CADname/NEXis/edge_vision/requirements_core.txt

numpy>=1.26,<2.0
opencv-python==4.10.0.84
requests>=2.32,<3
cv2-enumerate-cameras==1.1.12
