CADname/NEXis/app/web/assets/rig_reference.png

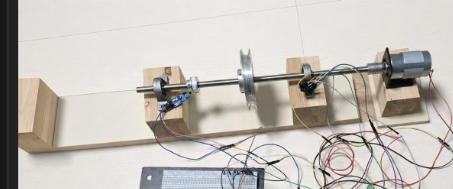
app/web/assets/rig_reference.png
