CADname/NEXis/docs/evaluation/feature_importance.csv

feature | importance
vib_ax_fft_total_energy | 0.022841326941740757
vib_ax_centered_rms | 0.021518155046494087
ax_rms | 0.021321313642015755
ax_fft_total_energy | 0.019961500723639985
ax_mean_abs_diff | 0.018666930597677878
vib_ax_q05 | 0.018539132703501063
vib_ax_std | 0.01814061380089551
ax_centered_rms | 0.01775506041951234
ax_var | 0.01736891581041225
ax_std | 0.01585659368558779
vib_ax_q95 | 0.01584396396627282
ax_iqr | 0.014160836240362438
ax_q95 | 0.014040463257992202
vib_ax_mean_abs_diff | 0.013955982796245478
vib_ax_iqr | 0.01363182951508748
ax_q05 | 0.013531222460089153
pwm_eq_median | 0.01277275607882244
pwm_eq_min | 0.011442873997963907
pwm_eq_q05 | 0.011442207293568114
ax_q75 | 0.011145094145351761
ay_median | 0.010799129972839763
vib_ax_q25 | 0.010654076008571609
pwm_eq_q75 | 0.010268697937284216
current_a_rms | 0.01020383544681336
pwm_eq_rms | 0.010178003566090188
pwm_eq_mean | 0.009994177080974014
pwm_eq_q95 | 0.009784141094847007
vib_ax_var | 0.00975105574194405
vib_ax_fft_15_30hz | 0.009672639114409732
ay_mean | 0.009424310437024592
acs_v_q95 | 0.009088402274476421
current_abs_mean_over_pwm_mean | 0.009057602223819976
pwm_eq_q25 | 0.008910322613374079
acs_v_rms | 0.008840024011165869
vib_ax_q75 | 0.008527674537947201
current_a_q05 | 0.008377809314269248
current_a_mean | 0.007773108881717905
pwm_eq_max | 0.007617440874078626
vib_ax_rms | 0.007548050671091398
current_a_q95 | 0.007475737540474022
acs_v_q25 | 0.007419951414322092
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
rpm_var | 0.00011975944122605263
vib_ay_dominant_freq | 0.00011945600777226854
rpm_fft_0_5hz | 0.00011679042688848543
vib_total_dominant_freq | 0.00011668877949068922
rpm_error_iqr | 0.00011223443318074505
rpm_error_ptp | 0.00010559064158554448
rpm_std | 0.00010518689751538301
rpm_iqr | 0.00010289869426213125
rpm_error_fft_15_30hz | 0.0001014084815672207
rpm_fft_total_energy | 9.811545128408473e-05
current_a_fft_0_5hz | 9.785438429443867e-05
acs_v_ptp | 9.752379922287292e-05
rpm_error_centered_rms | 9.72223357891814e-05
rpm_centered_rms | 9.585941786660273e-05
rpm_error_std | 9.481525569085122e-05
acs_v_spectral_spread | 9.313141887709359e-05
rpm_error_fft_0_5hz | 9.255021409763322e-05
total_current_corr | 9.033770345591622e-05
rpm_fft_15_30hz | 8.775610676664932e-05
rpm_error_var | 8.479115660224636e-05
rpm_fft_30_50hz | 7.97908124904852e-05
rpm_crest_factor | 7.911407737408273e-05
current_a_crest_factor | 7.814628266932045e-05
total_g_dominant_freq | 7.742065601655996e-05
acs_v_fft_0_5hz | 7.085889173998369e-05
ay_current_corr | 6.81832499439148e-05
az_current_corr | 6.512588289561261e-05
rpm_error_crest_factor | 6.033289721847867e-05
rpm_zcr | 6.0223892591135575e-05
rpm_vib_total_corr | 5.899271610973664e-05
rpm_error_zcr | 5.8956073629024985e-05
acs_v_crest_factor | 5.660127188325421e-05
ax_current_corr | 5.379428782710225e-05
rpm_spectral_spread | 4.242318456284739e-05
rpm_error_fft_total_energy | 4.161761290725309e-05
rpm_spectral_centroid | 4.065409392491601e-05
rpm_error_spectral_spread | 3.951437715421174e-05
rpm_error_spectral_centroid | 2.759924141874203e-05
rpm_error_dominant_freq | 1.8747235652247775e-05
rpm_current_corr | 1.4626233459767611e-05
rpm_dominant_freq | 1.039781791317215e-06
target_rpm_mean | 0.0
target_rpm_std | 0.0
vib_az_mean | 0.0
vib_total_mean | 0.0
pwm_eq_iqr | 0.0
pwm_eq_var | 0.0
pwm_eq_std | 0.0
duty_10bit_fft_total_energy | 0.0
duty_10bit_max_abs_diff | 0.0
duty_10bit_mean_abs_diff | 0.0
duty_10bit_zcr | 0.0
duty_10bit_crest_factor | 0.0
duty_10bit_ptp | 0.0
duty_10bit_centered_rms | 0.0
duty_10bit_iqr | 0.0
duty_10bit_var | 0.0
duty_10bit_std | 0.0
pwm_eq_spectral_spread | 0.0
pwm_eq_spectral_centroid | 0.0
pwm_eq_dominant_freq | 0.0
pwm_eq_fft_30_50hz | 0.0
pwm_eq_fft_15_30hz | 0.0
vib_ax_mean | 0.0
pwm_eq_fft_total_energy | 0.0
pwm_eq_max_abs_diff | 0.0
pwm_eq_zcr | 0.0
pwm_eq_mean_abs_diff | 0.0
pwm_eq_fft_5_15hz | 0.0
pwm_eq_fft_0_5hz | 0.0
pwm_eq_centered_rms | 0.0
pwm_eq_ptp | 0.0
vib_ay_mean | 0.0
duty_10bit_fft_5_15hz | 0.0
duty_10bit_dominant_freq | 0.0
duty_10bit_spectral_spread | 0.0
duty_10bit_fft_0_5hz | 0.0
duty_10bit_fft_15_30hz | 0.0
duty_10bit_fft_30_50hz | 0.0
duty_10bit_spectral_centroid | 0.0
