CADname/NEXis/docs/evaluation/csv_structure_check.csv

file | label | rows | rpm_mean | rpm_std | rpm_min | rpm_max | target_rpm_mean | rpm_error_mean | rpm_error_std | pwm_eq_mean | pwm_eq_std | acs_v_mean | acs_v_std | current_a_mean | current_a_std | ax_std | ay_std | az_std | total_g_std | state_mode | fault_type_mode
looseness_1000rpm_20261003_182908.csv | looseness | 989 | 1013.7632760364003 | 4.158534391472891 | 1005.48 | 1018.02 | 1000.0 | -13.763276036400404 | 4.158534391472892 | 50.25 | 0.0 | 2.22141213346815 | 0.008476578495732462 | -0.4937592517694641 | 0.12843413964583206 | 0.13910724921763432 | 0.22425402340945075 | 0.1594633347641606 | 0.1522566400938172 | 3 | looseness
looseness_1000rpm_20261003_182921.csv | looseness | 919 | 1025.1019477693146 | 2.1134196734731168 | 1021.35 | 1028.22 | 1000.0 | -25.10194776931447 | 2.1134196734731208 | 50.25 | 0.0 | 2.2219379760609357 | 0.008311339907777037 | -0.48579064200217625 | 0.12592871872577033 | 0.11853777779041468 | 0.23668175885504308 | 0.1668040516732486 | 0.15704965667657458 | 3 | looseness
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
