CADname/NEXis/docs/evaluation/file_validation.csv

model | test_file | true_label | true_label_name | pred_label | pred_label_name | file_correct | pred_file_ratio | pred_file_mean_prob | window_accuracy
RandomForest_fast | looseness_1000rpm_20261003_182908.csv | 3 | looseness | 3 | looseness | True | 1.0 | 0.9712121212121212 | 1.0
RandomForest_fast | looseness_1000rpm_20261003_182921.csv | 3 | looseness | 3 | looseness | True | 1.0 | 0.9768595041322314 | 1.0
RandomForest_fast | looseness_1000rpm_20261003_182935.csv | 3 | looseness | 3 | looseness | True | 1.0 | 0.9689393939393939 | 1.0
RandomForest_fast | looseness_1000rpm_20261003_182947.csv | 3 | looseness | 3 | looseness | True | 1.0 | 0.9825757575757575 | 1.0
RandomForest_fast | looseness_1000rpm_20261003_182959.csv | 3 | looseness | 3 | looseness | True | 1.0 | 0.9810606060606061 | 1.0
RandomForest_fast | looseness_1000rpm_20261003_183013.csv | 3 | looseness | 3 | looseness | True | 1.0 | 0.9810606060606061 | 1.0
RandomForest_fast | looseness_1000rpm_20261003_183025.csv | 3 | looseness | 3 | looseness | True | 1.0 | 0.8856060606060606 | 1.0
RandomForest_fast | looseness_1000rpm_20261003_183037.csv | 3 | looseness | 3 | looseness | True | 1.0 | 0.9962121212121214 | 1.0
RandomForest_fast | looseness_1000rpm_20261003_183055.csv | 3 | looseness | 3 | looseness | True | 1.0 | 0.9753787878787877 | 1.0
RandomForest_fast | looseness_1000rpm_20261003_183107.csv | 3 | looseness | 3 | looseness | True | 1.0 | 0.9830578512396694 | 1.0
RandomForest_fast | looseness_1000rpm_20261003_183118.csv | 3 | looseness | 3 | looseness | True | 1.0 | 0.968595041322314 | 1.0
RandomForest_fast | looseness_1000rpm_20261003_183131.csv | 3 | looseness | 3 | looseness | True | 1.0 | 0.975378787878788 | 1.0
RandomForest_fast | looseness_1000rpm_20261003_183146.csv | 3 | looseness | 3 | looseness | True | 1.0 | 0.9602272727272726 | 1.0
RandomForest_fast | looseness_1000rpm_20261003_183210.csv | 3 | looseness | 3 | looseness | True | 1.0 | 0.983712121212121 | 1.0
RandomForest_fast | looseness_1000rpm_20261003_183224.csv | 3 | looseness | 3 | looseness | True | 1.0 | 0.9268595041322314 | 1.0
RandomForest_fast | looseness_1000rpm_20261003_183236.csv | 3 | looseness | 3 | looseness | True | 1.0 | 0.9878787878787878 | 1.0
RandomForest_fast | looseness_1000rpm_20261003_183247.csv | 3 | looseness | 3 | looseness | True | 1.0 | 0.952651515151515 | 1.0
RandomForest_fast | looseness_1000rpm_20261003_183300.csv | 3 | looseness | 3 | looseness | True | 1.0 | 0.912121212121212 | 1.0
RandomForest_fast | looseness_1000rpm_20261003_184720.csv | 3 | looseness | 3 | looseness | True | 1.0 | 0.834469696969697 | 1.0
RandomForest_fast | looseness_1000rpm_20261003_184739.csv | 3 | looseness | 3 | looseness | True | 1.0 | 0.7609848484848486 | 1.0
RandomForest_fast | looseness_1000rpm_20261003_190001.csv | 3 | looseness | 3 | looseness | True | 1.0 | 0.9257575757575758 | 1.0
RandomForest_fast | looseness_1000rpm_20261003_190017.csv | 3 | looseness | 3 | looseness | True | 1.0 | 0.8924242424242422 | 1.0
RandomForest_fast | looseness_1000rpm_20261003_190035.csv | 3 | looseness | 3 | looseness | True | 1.0 | 0.9416666666666665 | 1.0
RandomForest_fast | looseness_1000rpm_20261003_190050.csv | 3 | looseness | 3 | looseness | True | 1.0 | 0.971969696969697 | 1.0
RandomForest_fast | looseness_1000rpm_20261003_190104.csv | 3 | looseness | 3 | looseness | True | 1.0 | 0.9768939393939394 | 1.0
RandomForest_fast | looseness_1000rpm_20261003_190116.csv | 3 | looseness | 3 | looseness | True | 1.0 | 0.953409090909091 | 1.0
RandomForest_fast | looseness_1000rpm_20261003_190135.csv | 3 | looseness | 3 | looseness | True | 1.0 | 0.9511363636363636 | 1.0
RandomForest_fast | looseness_1000rpm_20261003_190150.csv | 3 | looseness | 3 | looseness | True | 1.0 | 0.9507575757575758 | 1.0
RandomForest_fast | looseness_1000rpm_20261003_190201.csv | 3 | looseness | 3 | looseness | True | 1.0 | 0.9636363636363637 | 1.0
RandomForest_fast | looseness_1000rpm_20261003_190214.csv | 3 | looseness | 3 | looseness | True | 1.0 | 0.9060606060606061 | 1.0
RandomForest_fast | looseness_1000rpm_20261003_190234.csv | 3 | looseness | 3 | looseness | True | 1.0 | 0.8435606060606061 | 1.0
RandomForest_fast | looseness_1000rpm_20261003_190247.csv | 3 | looseness | 3 | looseness | True | 1.0 | 0.8309917355371902 | 1.0
RandomForest_fast | looseness_1000rpm_20261003_190308.csv | 3 | looseness | 3 | looseness | True | 1.0 | 0.9818181818181818 | 1.0
RandomForest_fast | looseness_1000rpm_20261003_190325.csv | 3 | looseness | 3 | looseness | True | 1.0 | 0.9875000000000002 | 1.0
RandomForest_fast | looseness_1000rpm_20261003_190338.csv | 3 | looseness | 3 | looseness | True | 1.0 | 0.8768939393939394 | 1.0
RandomForest_fast | looseness_1000rpm_20261003_190400.csv | 3 | looseness | 3 | looseness | True | 1.0 | 0.9325757575757575 | 1.0
RandomForest_fast | looseness_1000rpm_20261003_002418.csv | 3 | looseness | 3 | looseness | True | 1.0 | 0.8136363636363636 | 1.0
RandomForest_fast | looseness_1000rpm_20261003_002435.csv | 3 | looseness | 3 | looseness | True | 1.0 | 0.8848484848484848 | 1.0
RandomForest_fast | looseness_1000rpm_20261003_002450.csv | 3 | looseness | 3 | looseness | True | 1.0 | 0.9363636363636362 | 1.0
RandomForest_fast | looseness_1000rpm_20261003_002511.csv | 3 | looseness | 3 | looseness | True | 1.0 | 0.6983471074380164 | 1.0
RandomForest_fast | looseness_1000rpm_20261003_002525.csv | 3 | looseness | 3 | looseness | True | 1.0 | 0.9016528925619837 | 1.0
RandomForest_fast | looseness_1000rpm_20261003_002557.csv | 3 | looseness | 3 | looseness | True | 1.0 | 0.9526515151515151 | 1.0
RandomForest_fast | looseness_1000rpm_20261003_002628.csv | 3 | looseness | 3 | looseness | True | 1.0 | 0.8958677685950412 | 1.0
RandomForest_fast | looseness_1000rpm_20261003_002644.csv | 3 | looseness | 3 | looseness | True | 1.0 | 0.9125 | 1.0
RandomForest_fast | looseness_1000rpm_20261003_230148.csv | 3 | looseness | 3 | looseness | True | 1.0 | 0.9602272727272728 | 1.0
RandomForest_fast | looseness_1000rpm_20261003_230201.csv | 3 | looseness | 3 | looseness | True | 1.0 | 0.9568181818181817 | 1.0
RandomForest_fast | looseness_1000rpm_20261003_230237.csv | 3 | looseness | 3 | looseness | True | 1.0 | 0.9859504132231405 | 1.0
RandomForest_fast | looseness_1000rpm_20261003_230302.csv | 3 | looseness | 3 | looseness | True | 1.0 | 0.9892561983471073 | 1.0
RandomForest_fast | looseness_1000rpm_20261003_230317.csv | 3 | looseness | 3 | looseness | True | 1.0 | 0.9445454545454546 | 1.0
RandomForest_fast | looseness_1000rpm_20261003_230345.csv | 3 | looseness | 3 | looseness | True | 1.0 | 0.934090909090909 | 1.0
RandomForest_fast | looseness_1000rpm_20261003_230400.csv | 3 | looseness | 3 | looseness | True | 1.0 | 0.9351239669421488 | 1.0
RandomForest_fast | looseness_1000rpm_20261003_230411.csv | 3 | looseness | 3 | looseness | True | 1.0 | 0.9698347107438017 | 1.0
RandomForest_fast | looseness_1000rpm_20261003_230430.csv | 3 | looseness | 3 | looseness | True | 1.0 | 0.9665289256198348 | 1.0
RandomForest_fast | looseness_1000rpm_20261003_230444.csv | 3 | looseness | 3 | looseness | True | 1.0 | 0.9446280991735537 | 1.0
RandomForest_fast | looseness_1000rpm_20261003_230458.csv | 3 | looseness | 3 | looseness | True | 1.0 | 0.9793388429752067 | 1.0
RandomForest_fast | looseness_1000rpm_20261003_232731.csv | 3 | looseness | 3 | looseness | True | 1.0 | 0.9583916083916084 | 1.0
RandomForest_fast | looseness_1000rpm_20261003_232744.csv | 3 | looseness | 3 | looseness | True | 1.0 | 0.9904958677685951 | 1.0
RandomForest_fast | looseness_1000rpm_20261003_232756.csv | 3 | looseness | 3 | looseness | True | 1.0 | 0.9892561983471075 | 1.0
RandomForest_fast | looseness_1000rpm_20261003_232807.csv | 3 | looseness | 3 | looseness | True | 1.0 | 0.9787878787878787 | 1.0
RandomForest_fast | looseness_1000rpm_20261003_232824.csv | 3 | looseness | 3 | looseness | True | 1.0 | 0.975 | 1.0
RandomForest_fast | looseness_1000rpm_20261003_232848.csv | 3 | looseness | 3 | looseness | True | 1.0 | 0.9772727272727273 | 1.0
RandomForest_fast | looseness_1000rpm_20261003_232901.csv | 3 | looseness | 3 | looseness | True | 1.0 | 0.9897727272727272 | 1.0
RandomForest_fast | looseness_1000rpm_20261003_232914.csv | 3 | looseness | 3 | looseness | True | 1.0 | 0.9859848484848485 | 1.0
RandomForest_fast | looseness_1000rpm_20261003_232927.csv | 3 | looseness | 3 | looseness | True | 1.0 | 0.9777272727272728 | 1.0
RandomForest_fast | looseness_1000rpm_20261003_232941.csv | 3 | looseness | 3 | looseness | True | 1.0 | 0.9392561983471073 | 1.0
RandomForest_fast | looseness_1000rpm_20261003_233007.csv | 3 | looseness | 3 | looseness | True | 1.0 | 0.9483471074380165 | 1.0
RandomForest_fast | looseness_1000rpm_20261003_233225.csv | 3 | looseness | 3 | looseness | True | 1.0 | 0.9882575757575757 | 1.0
RandomForest_fast | looseness_1000rpm_20261003_233248.csv | 3 | looseness | 3 | looseness | True | 1.0 | 0.9904958677685951 | 1.0
RandomForest_fast | looseness_1000rpm_20261003_233315.csv | 3 | looseness | 3 | looseness | True | 1.0 | 0.9863636363636364 | 1.0
RandomForest_fast | looseness_1000rpm_20261003_233616.csv | 3 | looseness | 3 | looseness | True | 1.0 | 0.9818181818181819 | 1.0
RandomForest_fast | looseness_1000rpm_20261003_233635.csv | 3 | looseness | 3 | looseness | True | 1.0 | 0.9674242424242424 | 1.0
RandomForest_fast | looseness_1000rpm_20261003_233658.csv | 3 | looseness | 3 | looseness | True | 1.0 | 0.9926573426573425 | 1.0
RandomForest_fast | looseness_1000rpm_20261003_233715.csv | 3 | looseness | 3 | looseness | True | 1.0 | 0.9852272727272727 | 1.0
RandomForest_fast | looseness_1000rpm_20261003_233732.csv | 3 | looseness | 3 | looseness | True | 1.0 | 0.9776515151515152 | 1.0
RandomForest_fast | looseness_1000rpm_20261003_233743.csv | 3 | looseness | 3 | looseness | True | 1.0 | 0.9822314049586776 | 1.0
RandomForest_fast | looseness_1000rpm_20261003_000001.csv | 3 | looseness | 3 | looseness | True | 1.0 | 0.8305785123966942 | 1.0
RandomForest_fast | looseness_1000rpm_20261003_000024.csv | 3 | looseness | 3 | looseness | True | 1.0 | 0.9349999999999999 | 1.0
RandomForest_fast | looseness_1000rpm_20261003_000101.csv | 3 | looseness | 3 | looseness | True | 1.0 | 0.864090909090909 | 1.0
RandomForest_fast | looseness_1000rpm_20261003_000132.csv | 3 | looseness | 3 | looseness | True | 1.0 | 0.8669421487603305 | 1.0
RandomForest_fast | looseness_1000rpm_20261003_000158.csv | 3 | looseness | 3 | looseness | True | 1.0 | 0.8314049586776858 | 1.0
RandomForest_fast | misalignment_1000rpm_20261002_204030.csv | 2 | misalignment | 2 | misalignment | True | 1.0 | 0.9681818181818181 | 1.0
RandomForest_fast | misalignment_1000rpm_20261002_204042.csv | 2 | misalignment | 2 | misalignment | True | 1.0 | 0.9742424242424242 | 1.0
RandomForest_fast | misalignment_1000rpm_20261002_204057.csv | 2 | misalignment | 2 | misalignment | True | 1.0 | 0.956439393939394 | 1.0
RandomForest_fast | misalignment_1000rpm_20261002_204109.csv | 2 | misalignment | 2 | misalignment | True | 1.0 | 0.9488636363636362 | 1.0
RandomForest_fast | misalignment_1000rpm_20261002_204122.csv | 2 | misalignment | 2 | misalignment | True | 1.0 | 0.9905303030303031 | 1.0
RandomForest_fast | misalignment_1000rpm_20261002_204146.csv | 2 | misalignment | 2 | misalignment | True | 1.0 | 0.6950757575757575 | 1.0
RandomForest_fast | misalignment_1000rpm_20261002_204206.csv | 2 | misalignment | 2 | misalignment | True | 1.0 | 0.9518939393939395 | 1.0
RandomForest_fast | misalignment_1000rpm_20261002_204217.csv | 2 | misalignment | 2 | misalignment | True | 1.0 | 0.9814393939393938 | 1.0
RandomForest_fast | misalignment_1000rpm_20261002_204229.csv | 2 | misalignment | 2 | misalignment | True | 1.0 | 0.9852272727272725 | 1.0
RandomForest_fast | misalignment_1000rpm_20261002_204248.csv | 2 | misalignment | 2 | misalignment | True | 1.0 | 0.9784090909090909 | 1.0
RandomForest_fast | misalignment_1000rpm_20261002_204304.csv | 2 | misalignment | 2 | misalignment | True | 1.0 | 0.9897727272727272 | 1.0
RandomForest_fast | misalignment_1000rpm_20261002_204315.csv | 2 | misalignment | 2 | misalignment | True | 1.0 | 0.983712121212121 | 1.0
RandomForest_fast | misalignment_1000rpm_20261002_204658.csv | 2 | misalignment | 2 | misalignment | True | 1.0 | 0.9912878787878788 | 1.0
RandomForest_fast | misalignment_1000rpm_20261002_204709.csv | 2 | misalignment | 2 | misalignment | True | 1.0 | 0.9878787878787879 | 1.0
RandomForest_fast | misalignment_1000rpm_20261002_204720.csv | 2 | misalignment | 2 | misalignment | True | 1.0 | 0.9795454545454545 | 1.0
RandomForest_fast | misalignment_1000rpm_20261002_204731.csv | 2 | misalignment | 2 | misalignment | True | 1.0 | 0.9928030303030303 | 1.0
RandomForest_fast | misalignment_1000rpm_20261002_204750.csv | 2 | misalignment | 2 | misalignment | True | 1.0 | 0.9882575757575758 | 1.0
RandomForest_fast | misalignment_1000rpm_20261002_204810.csv | 2 | misalignment | 2 | misalignment | True | 1.0 | 0.9613636363636363 | 1.0
RandomForest_fast | misalignment_1000rpm_20261002_204821.csv | 2 | misalignment | 2 | misalignment | True | 1.0 | 0.9833333333333333 | 1.0
RandomForest_fast | misalignment_1000rpm_20261002_222054.csv | 2 | misalignment | 2 | misalignment | True | 1.0 | 0.890530303030303 | 1.0
RandomForest_fast | misalignment_1000rpm_20261002_222105.csv | 2 | misalignment | 2 | misalignment | True | 1.0 | 0.9144628099173552 | 1.0
RandomForest_fast | misalignment_1000rpm_20261002_222117.csv | 2 | misalignment | 2 | misalignment | True | 1.0 | 0.9337121212121211 | 1.0
RandomForest_fast | misalignment_1000rpm_20261002_222129.csv | 2 | misalignment | 2 | misalignment | True | 1.0 | 0.9348484848484849 | 1.0
RandomForest_fast | misalignment_1000rpm_20261002_222140.csv | 2 | misalignment | 2 | misalignment | True | 1.0 | 0.921590909090909 | 1.0
RandomForest_fast | misalignment_1000rpm_20261002_225101.csv | 2 | misalignment | 2 | misalignment | True | 1.0 | 0.9621212121212123 | 1.0
RandomForest_fast | misalignment_1000rpm_20261002_225112.csv | 2 | misalignment | 2 | misalignment | True | 1.0 | 0.962396694214876 | 1.0
RandomForest_fast | misalignment_1000rpm_20261002_225124.csv | 2 | misalignment | 2 | misalignment | True | 1.0 | 0.9636363636363637 | 1.0
RandomForest_fast | misalignment_1000rpm_20261002_225135.csv | 2 | misalignment | 2 | misalignment | True | 1.0 | 0.9648760330578512 | 1.0
RandomForest_fast | misalignment_1000rpm_20261002_225154.csv | 2 | misalignment | 2 | misalignment | True | 1.0 | 0.9640151515151515 | 1.0
RandomForest_fast | misalignment_1000rpm_20261002_225207.csv | 2 | misalignment | 2 | misalignment | True | 1.0 | 0.978030303030303 | 1.0
RandomForest_fast | misalignment_1000rpm_20261002_225226.csv | 2 | misalignment | 2 | misalignment | True | 1.0 | 0.9140909090909091 | 1.0
RandomForest_fast | misalignment_1000rpm_20261002_225238.csv | 2 | misalignment | 2 | misalignment | True | 1.0 | 0.9338842975206613 | 1.0
RandomForest_fast | misalignment_1000rpm_20261002_230437.csv | 2 | misalignment | 2 | misalignment | True | 1.0 | 0.734090909090909 | 1.0
RandomForest_fast | misalignment_1000rpm_20261002_230448.csv | 2 | misalignment | 2 | misalignment | True | 1.0 | 0.6609848484848485 | 1.0
RandomForest_fast | misalignment_1000rpm_20261002_230506.csv | 2 | misalignment | 2 | misalignment | True | 1.0 | 0.8946280991735538 | 1.0
RandomForest_fast | misalignment_1000rpm_20261002_230521.csv | 2 | misalignment | 2 | misalignment | True | 1.0 | 0.8655303030303031 | 1.0
RandomForest_fast | misalignment_1000rpm_20261002_231617.csv | 2 | misalignment | 2 | misalignment | True | 1.0 | 0.7734848484848484 | 1.0
RandomForest_fast | misalignment_1000rpm_20261002_231631.csv | 2 | misalignment | 2 | misalignment | True | 1.0 | 0.8079545454545456 | 1.0
RandomForest_fast | misalignment_1000rpm_20261002_231647.csv | 2 | misalignment | 2 | misalignment | True | 1.0 | 0.8609848484848485 | 1.0
RandomForest_fast | misalignment_1000rpm_20261002_231709.csv | 2 | misalignment | 2 | misalignment | True | 1.0 | 0.8409090909090908 | 1.0
RandomForest_fast | misalignment_1000rpm_20261002_231721.csv | 2 | misalignment | 2 | misalignment | True | 1.0 | 0.8830578512396695 | 1.0
RandomForest_fast | misalignment_1000rpm_20261002_233257.csv | 2 | misalignment | 2 | misalignment | True | 1.0 | 0.9268595041322314 | 1.0
RandomForest_fast | misalignment_1000rpm_20261002_233309.csv | 2 | misalignment | 2 | misalignment | True | 1.0 | 0.9173553719008264 | 1.0
RandomForest_fast | misalignment_1000rpm_20261002_233324.csv | 2 | misalignment | 2 | misalignment | True | 0.9166666666666666 | 0.7382575757575758 | 0.9166666666666666
RandomForest_fast | misalignment_1000rpm_20261002_233340.csv | 2 | misalignment | 2 | misalignment | True | 1.0 | 0.8920454545454547 | 1.0
RandomForest_fast | misalignment_1000rpm_20261002_233400.csv | 2 | misalignment | 2 | misalignment | True | 1.0 | 0.7962809917355372 | 1.0
RandomForest_fast | misalignment_1000rpm_20261002_233413.csv | 2 | misalignment | 2 | misalignment | True | 1.0 | 0.9206611570247933 | 1.0
RandomForest_fast | misalignment_1000rpm_20261002_233428.csv | 2 | misalignment | 2 | misalignment | True | 1.0 | 0.6863636363636364 | 1.0
RandomForest_fast | misalignment_1000rpm_20261002_233447.csv | 2 | misalignment | 2 | misalignment | True | 1.0 | 0.8363636363636363 | 1.0
RandomForest_fast | misalignment_1000rpm_20261002_233503.csv | 2 | misalignment | 2 | misalignment | True | 1.0 | 0.8169421487603308 | 1.0
RandomForest_fast | misalignment_1000rpm_20261002_223814.csv | 2 | misalignment | 2 | misalignment | True | 1.0 | 0.9512396694214877 | 1.0
RandomForest_fast | misalignment_1000rpm_20261002_223830.csv | 2 | misalignment | 2 | misalignment | True | 1.0 | 0.5045454545454546 | 1.0
RandomForest_fast | misalignment_1000rpm_20261002_223845.csv | 2 | misalignment | 2 | misalignment | True | 1.0 | 0.849586776859504 | 1.0
RandomForest_fast | misalignment_1000rpm_20261002_225704.csv | 2 | misalignment | 0 | normal | False | 1.0 | 0.6109848484848485 | 0.0
RandomForest_fast | misalignment_1000rpm_20261002_225735.csv | 2 | misalignment | 0 | normal | False | 1.0 | 0.6927272727272727 | 0.0
RandomForest_fast | misalignment_1000rpm_20261002_225752.csv | 2 | misalignment | 0 | normal | False | 1.0 | 0.6508264462809917 | 0.0
RandomForest_fast | misalignment_1000rpm_20261002_234315.csv | 2 | misalignment | 2 | misalignment | True | 1.0 | 0.5016528925619835 | 1.0
RandomForest_fast | misalignment_1000rpm_20261002_234344.csv | 2 | misalignment | 0 | normal | False | 1.0 | 0.518595041322314 | 0.0
RandomForest_fast | misalignment_1000rpm_20261002_223620.csv | 2 | misalignment | 2 | misalignment | True | 1.0 | 0.7840909090909092 | 1.0
RandomForest_fast | misalignment_1000rpm_20261002_223646.csv | 2 | misalignment | 2 | misalignment | True | 1.0 | 0.5621212121212121 | 1.0
RandomForest_fast | misalignment_1000rpm_20261002_223721.csv | 2 | misalignment | 2 | misalignment | True | 0.8333333333333334 | 0.5431818181818181 | 0.8333333333333334
RandomForest_fast | misalignment_1000rpm_20261002_212235.csv | 2 | misalignment | 0 | normal | False | 1.0 | 0.49132231404958676 | 0.0
RandomForest_fast | misalignment_1000rpm_20261002_212427.csv | 2 | misalignment | 2 | misalignment | True | 1.0 | 0.41856060606060613 | 1.0
RandomForest_fast | normal_1000rpm_20261002_175246.csv | 0 | normal | 0 | normal | True | 1.0 | 0.9928030303030303 | 1.0
RandomForest_fast | normal_1000rpm_20261002_175304.csv | 0 | normal | 0 | normal | True | 1.0 | 0.9882575757575758 | 1.0
RandomForest_fast | normal_1000rpm_20261002_175317.csv | 0 | normal | 0 | normal | True | 1.0 | 0.9905303030303031 | 1.0
RandomForest_fast | normal_1000rpm_20261002_175342.csv | 0 | normal | 0 | normal | True | 1.0 | 0.9901515151515152 | 1.0
RandomForest_fast | normal_1000rpm_20261002_175354.csv | 0 | normal | 0 | normal | True | 1.0 | 0.9863636363636363 | 1.0
RandomForest_fast | normal_1000rpm_20261002_175405.csv | 0 | normal | 0 | normal | True | 1.0 | 0.993939393939394 | 1.0
RandomForest_fast | normal_1000rpm_20261002_175417.csv | 0 | normal | 0 | normal | True | 1.0 | 0.9856060606060607 | 1.0
RandomForest_fast | normal_1000rpm_20261002_175442.csv | 0 | normal | 0 | normal | True | 1.0 | 0.9378787878787879 | 1.0
RandomForest_fast | normal_1000rpm_20261002_175454.csv | 0 | normal | 0 | normal | True | 1.0 | 0.9977272727272727 | 1.0
RandomForest_fast | normal_1000rpm_20261002_175505.csv | 0 | normal | 0 | normal | True | 1.0 | 0.9867424242424243 | 1.0
RandomForest_fast | normal_1000rpm_20261002_175517.csv | 0 | normal | 0 | normal | True | 1.0 | 0.9954545454545456 | 1.0
RandomForest_fast | normal_1000rpm_20261002_175531.csv | 0 | normal | 0 | normal | True | 1.0 | 0.9890151515151516 | 1.0
RandomForest_fast | normal_1000rpm_20261002_175543.csv | 0 | normal | 0 | normal | True | 1.0 | 0.9880165289256198 | 1.0
RandomForest_fast | normal_1000rpm_20261002_175606.csv | 0 | normal | 0 | normal | True | 1.0 | 0.9727272727272727 | 1.0
RandomForest_fast | normal_1000rpm_20261002_175617.csv | 0 | normal | 0 | normal | True | 1.0 | 0.9886363636363638 | 1.0
RandomForest_fast | normal_1000rpm_20261002_175630.csv | 0 | normal | 0 | normal | True | 1.0 | 0.9916666666666667 | 1.0
RandomForest_fast | normal_1000rpm_20261002_175641.csv | 0 | normal | 0 | normal | True | 1.0 | 0.994318181818182 | 1.0
RandomForest_fast | normal_1000rpm_20261002_175654.csv | 0 | normal | 0 | normal | True | 1.0 | 0.9863636363636364 | 1.0
RandomForest_fast | normal_1000rpm_20261002_190750.csv | 0 | normal | 0 | normal | True | 1.0 | 0.9768939393939394 | 1.0
RandomForest_fast | normal_1000rpm_20261002_190802.csv | 0 | normal | 0 | normal | True | 1.0 | 0.981439393939394 | 1.0
RandomForest_fast | normal_1000rpm_20261002_190813.csv | 0 | normal | 0 | normal | True | 1.0 | 0.8212121212121213 | 1.0
RandomForest_fast | normal_1000rpm_20261002_190831.csv | 0 | normal | 0 | normal | True | 1.0 | 0.9749999999999998 | 1.0
RandomForest_fast | normal_1000rpm_20261002_190906.csv | 0 | normal | 0 | normal | True | 1.0 | 0.9818181818181819 | 1.0
RandomForest_fast | normal_1000rpm_20261002_190919.csv | 0 | normal | 0 | normal | True | 1.0 | 0.975378787878788 | 1.0
RandomForest_fast | normal_1000rpm_20261002_190931.csv | 0 | normal | 0 | normal | True | 1.0 | 0.9575757575757575 | 1.0
RandomForest_fast | normal_1000rpm_20261002_190945.csv | 0 | normal | 0 | normal | True | 1.0 | 0.9617424242424243 | 1.0
RandomForest_fast | normal_1000rpm_20261002_221954.csv | 0 | normal | 0 | normal | True | 1.0 | 0.8303030303030304 | 1.0
RandomForest_fast | normal_1000rpm_20261002_222005.csv | 0 | normal | 0 | normal | True | 1.0 | 0.7765151515151515 | 1.0
RandomForest_fast | normal_1000rpm_20261002_222017.csv | 0 | normal | 0 | normal | True | 1.0 | 0.846969696969697 | 1.0
RandomForest_fast | normal_1000rpm_20261002_230321.csv | 0 | normal | 0 | normal | True | 0.8181818181818182 | 0.6384297520661156 | 0.8181818181818182
RandomForest_fast | normal_1000rpm_20261002_230334.csv | 0 | normal | 0 | normal | True | 0.9090909090909091 | 0.6640495867768595 | 0.9090909090909091
RandomForest_fast | normal_1000rpm_20261002_230345.csv | 0 | normal | 0 | normal | True | 1.0 | 0.6057851239669423 | 1.0
RandomForest_fast | normal_1000rpm_20261002_230357.csv | 0 | normal | 0 | normal | True | 0.7272727272727273 | 0.6297520661157024 | 0.7272727272727273
RandomForest_fast | normal_1000rpm_20261002_230555.csv | 0 | normal | 2 | misalignment | False | 1.0 | 0.6806818181818182 | 0.0
RandomForest_fast | normal_1000rpm_20261002_230610.csv | 0 | normal | 0 | normal | True | 0.6363636363636364 | 0.44008264462809926 | 0.6363636363636364
RandomForest_fast | normal_1000rpm_20261002_234643.csv | 0 | normal | 0 | normal | True | 1.0 | 0.8739669421487603 | 1.0
RandomForest_fast | normal_1000rpm_20261002_234656.csv | 0 | normal | 0 | normal | True | 1.0 | 0.8537190082644628 | 1.0
RandomForest_fast | normal_1000rpm_20261002_234736.csv | 0 | normal | 0 | normal | True | 1.0 | 0.8202479338842974 | 1.0
RandomForest_fast | normal_1000rpm_20261002_223656.csv | 0 | normal | 0 | normal | True | 1.0 | 0.8696969696969696 | 1.0
RandomForest_fast | normal_1000rpm_20261002_223714.csv | 0 | normal | 0 | normal | True | 1.0 | 0.8764462809917355 | 1.0
RandomForest_fast | normal_1000rpm_20261002_223733.csv | 0 | normal | 0 | normal | True | 1.0 | 0.8045454545454546 | 1.0
RandomForest_fast | normal_1000rpm_20261002_225313.csv | 0 | normal | 0 | normal | True | 1.0 | 0.7026515151515151 | 1.0
RandomForest_fast | normal_1000rpm_20261002_225327.csv | 0 | normal | 0 | normal | True | 1.0 | 0.7651515151515151 | 1.0
RandomForest_fast | normal_1000rpm_20261002_225357.csv | 0 | normal | 0 | normal | True | 1.0 | 0.756818181818182 | 1.0
RandomForest_fast | normal_1000rpm_20261002_225427.csv | 0 | normal | 0 | normal | True | 1.0 | 0.775206611570248 | 1.0
RandomForest_fast | normal_1000rpm_20261002_225527.csv | 0 | normal | 0 | normal | True | 1.0 | 0.7198347107438017 | 1.0
RandomForest_fast | normal_1000rpm_20261002_225553.csv | 0 | normal | 2 | misalignment | False | 0.6666666666666666 | 0.5333333333333333 | 0.3333333333333333
RandomForest_fast | normal_1000rpm_20261002_225624.csv | 0 | normal | 0 | normal | True | 1.0 | 0.6863636363636363 | 1.0
RandomForest_fast | normal_1000rpm_20261002_230007.csv | 0 | normal | 0 | normal | True | 1.0 | 0.6195454545454546 | 1.0
RandomForest_fast | normal_1000rpm_20261002_234151.csv | 0 | normal | 0 | normal | True | 1.0 | 0.765702479338843 | 1.0
RandomForest_fast | normal_1000rpm_20261002_234219.csv | 0 | normal | 0 | normal | True | 1.0 | 0.8666666666666666 | 1.0
RandomForest_fast | normal_1000rpm_20261002_234237.csv | 0 | normal | 0 | normal | True | 1.0 | 0.8109848484848485 | 1.0
RandomForest_fast | normal_1000rpm_20261002_234500.csv | 0 | normal | 0 | normal | True | 1.0 | 0.7326446280991735 | 1.0
RandomForest_fast | normal_1000rpm_20261002_011434.csv | 0 | normal | 0 | normal | True | 1.0 | 0.8238636363636364 | 1.0
RandomForest_fast | normal_1000rpm_20261002_011447.csv | 0 | normal | 0 | normal | True | 1.0 | 0.8424242424242424 | 1.0
RandomForest_fast | normal_1000rpm_20261002_011500.csv | 0 | normal | 0 | normal | True | 1.0 | 0.7541666666666665 | 1.0
RandomForest_fast | normal_1000rpm_20261002_011541.csv | 0 | normal | 0 | normal | True | 1.0 | 0.8 | 1.0
RandomForest_fast | normal_1000rpm_20261002_011618.csv | 0 | normal | 0 | normal | True | 1.0 | 0.8714876033057852 | 1.0
RandomForest_fast | normal_1000rpm_20261002_215349.csv | 0 | normal | 0 | normal | True | 1.0 | 0.6450757575757576 | 1.0
RandomForest_fast | normal_1000rpm_20261002_223226.csv | 0 | normal | 0 | normal | True | 1.0 | 0.9238636363636364 | 1.0
RandomForest_fast | normal_1000rpm_20261002_223239.csv | 0 | normal | 0 | normal | True | 1.0 | 0.9617424242424241 | 1.0
RandomForest_fast | normal_1000rpm_20261002_223251.csv | 0 | normal | 0 | normal | True | 1.0 | 0.9484848484848484 | 1.0
RandomForest_fast | normal_1000rpm_20261002_223303.csv | 0 | normal | 0 | normal | True | 1.0 | 0.9503787878787877 | 1.0
RandomForest_fast | normal_1000rpm_20261002_223422.csv | 0 | normal | 0 | normal | True | 1.0 | 0.6731404958677687 | 1.0
RandomForest_fast | normal_1000rpm_20261002_000500.csv | 0 | normal | 0 | normal | True | 1.0 | 0.8356060606060608 | 1.0
RandomForest_fast | normal_1000rpm_20261002_000512.csv | 0 | normal | 0 | normal | True | 1.0 | 0.8785123966942149 | 1.0
RandomForest_fast | normal_1000rpm_20261002_000525.csv | 0 | normal | 0 | normal | True | 1.0 | 0.9238636363636362 | 1.0
RandomForest_fast | normal_1000rpm_20261002_000540.csv | 0 | normal | 0 | normal | True | 1.0 | 0.9087412587412589 | 1.0
RandomForest_fast | normal_1000rpm_20261002_000605.csv | 0 | normal | 0 | normal | True | 1.0 | 0.9189393939393938 | 1.0
RandomForest_fast | normal_1000rpm_20261002_005417.csv | 0 | normal | 0 | normal | True | 1.0 | 0.8090909090909091 | 1.0
RandomForest_fast | normal_1000rpm_20261002_011710.csv | 0 | normal | 0 | normal | True | 1.0 | 0.7242424242424245 | 1.0
RandomForest_fast | normal_1000rpm_20261002_210328.csv | 0 | normal | 3 | looseness | False | 0.8181818181818182 | 0.3942148760330579 | 0.0
RandomForest_fast | unbalance_1000rpm_20261003_205421.csv | 1 | unbalance | 1 | unbalance | True | 1.0 | 0.9882575757575757 | 1.0
RandomForest_fast | unbalance_1000rpm_20261003_205436.csv | 1 | unbalance | 1 | unbalance | True | 1.0 | 0.9943181818181818 | 1.0
RandomForest_fast | unbalance_1000rpm_20261003_205448.csv | 1 | unbalance | 1 | unbalance | True | 1.0 | 0.9969696969696971 | 1.0
RandomForest_fast | unbalance_1000rpm_20261003_205502.csv | 1 | unbalance | 1 | unbalance | True | 1.0 | 0.9795454545454546 | 1.0
RandomForest_fast | unbalance_1000rpm_20261003_205514.csv | 1 | unbalance | 1 | unbalance | True | 1.0 | 1.0 | 1.0
RandomForest_fast | unbalance_1000rpm_20261003_205525.csv | 1 | unbalance | 1 | unbalance | True | 1.0 | 1.0 | 1.0
RandomForest_fast | unbalance_1000rpm_20261003_205548.csv | 1 | unbalance | 1 | unbalance | True | 1.0 | 0.9299242424242423 | 1.0
RandomForest_fast | unbalance_1000rpm_20261003_205600.csv | 1 | unbalance | 1 | unbalance | True | 1.0 | 0.9822314049586777 | 1.0
RandomForest_fast | unbalance_1000rpm_20261003_010841.csv | 1 | unbalance | 1 | unbalance | True | 1.0 | 0.9719008264462811 | 1.0
RandomForest_fast | unbalance_1000rpm_20261003_010901.csv | 1 | unbalance | 1 | unbalance | True | 1.0 | 0.8466942148760331 | 1.0
