CADname/NEXis/docs/evaluation/model_selection_summary.csv

model | file_accuracy | file_macro_f1 | window_accuracy | window_macro_f1 | score | file_acc_normal | file_acc_unbalance | file_acc_misalignment | file_acc_looseness
RandomForest_fast | 0.9644444444444444 | 0.9705209325555351 | 0.9620834929145922 | 0.9685179602150673 | 2.0301296850932973 | 0.9583333333333334 | 1.0 | 0.9206349206349206 | 1.0
ExtraTrees_fast | 0.96 | 0.9563622628840021 | 0.9617004978935274 | 0.95761019210396 | 2.0131909290963033 | 0.9722222222222222 | 1.0 | 0.8888888888888888 | 1.0
