CADname/NEXis/(commit log)

2026-10-03 Initial NEXis release
    [csv_structure_check.csv, feature_importance.csv, file_classification_report.csv, file_confusion_matrix.csv, file_validation.csv, looseness_1000rpm_20261003_000001.csv, looseness_1000rpm_20261003_000024.csv, looseness_1000rpm_20261003_000101.csv]
2026-10-07 Sync current NEXis vision and operations platform
2026-10-07 docs: add physical rig wiring guide
2026-10-07 docs: link hardware wiring and pin map
2026-10-19 ci: validate sign-in flow while keeping repository security checks
